Fridoku/gausskanone/README.md

# gausskanone
Fachpraktikum Gausskanone WS1920
