Fridoku/gausskanone/Slide_master_16_9_option1.pptx

## Gausskanone Leistungselektronik

## Schaltplan der Platine

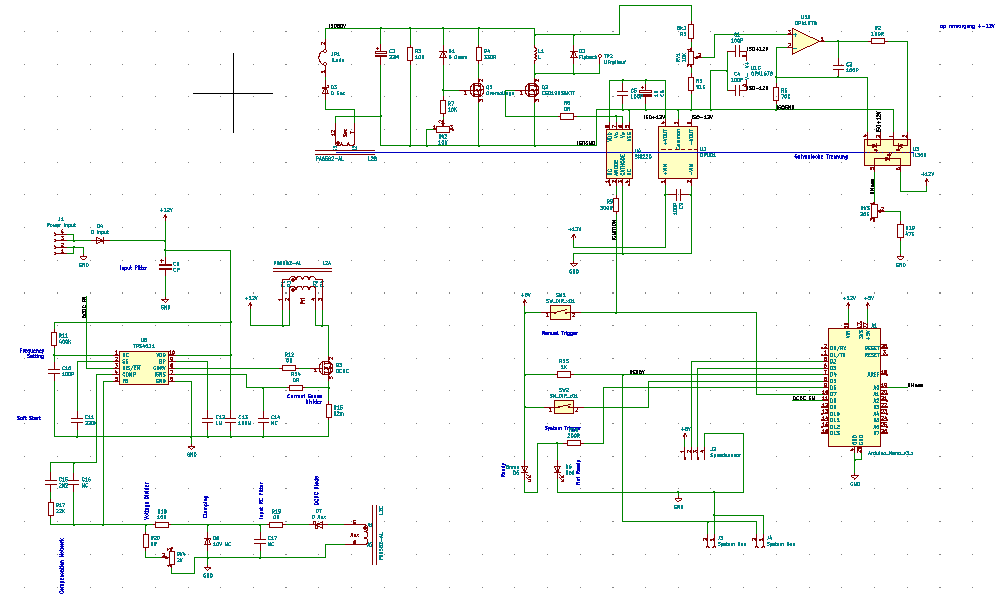
[picture p1: figure]

## Platine

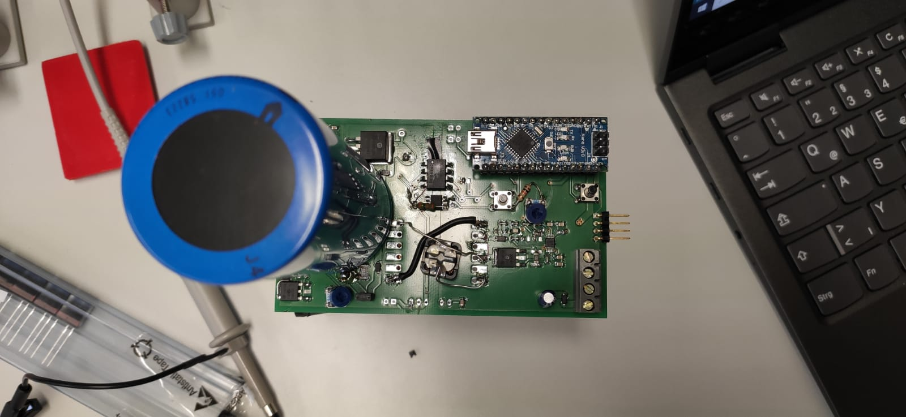
[picture p2: figure]

## Kondensator- und Spulenkreis

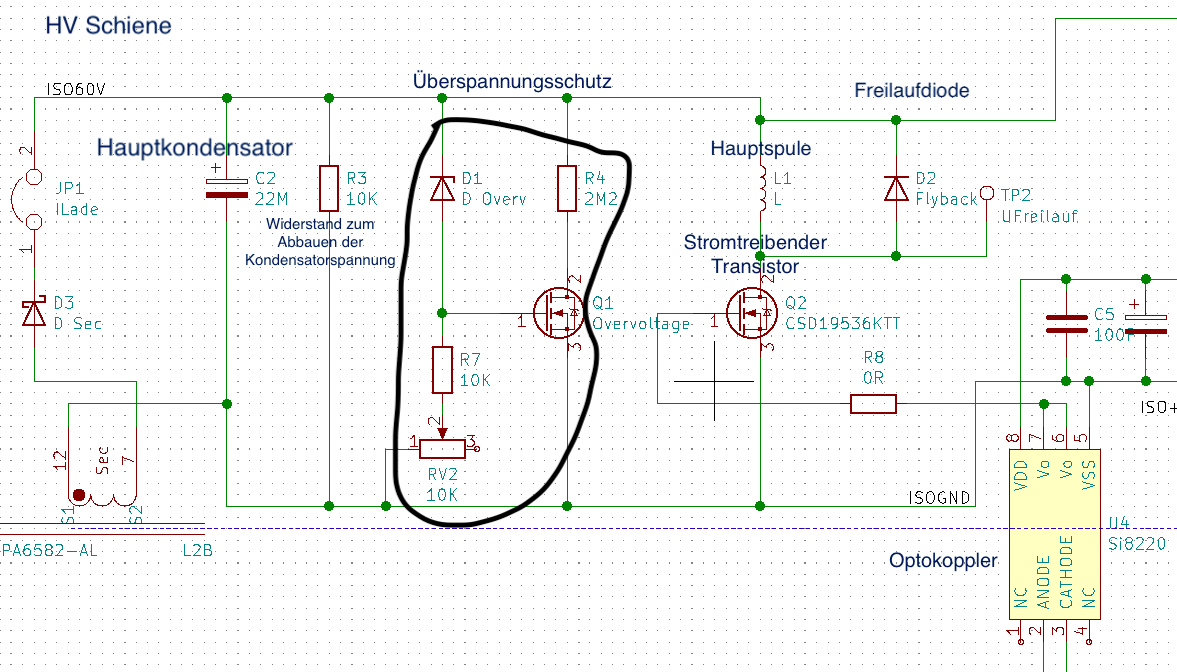
[picture p3: figure]

## Überspannungsschutz

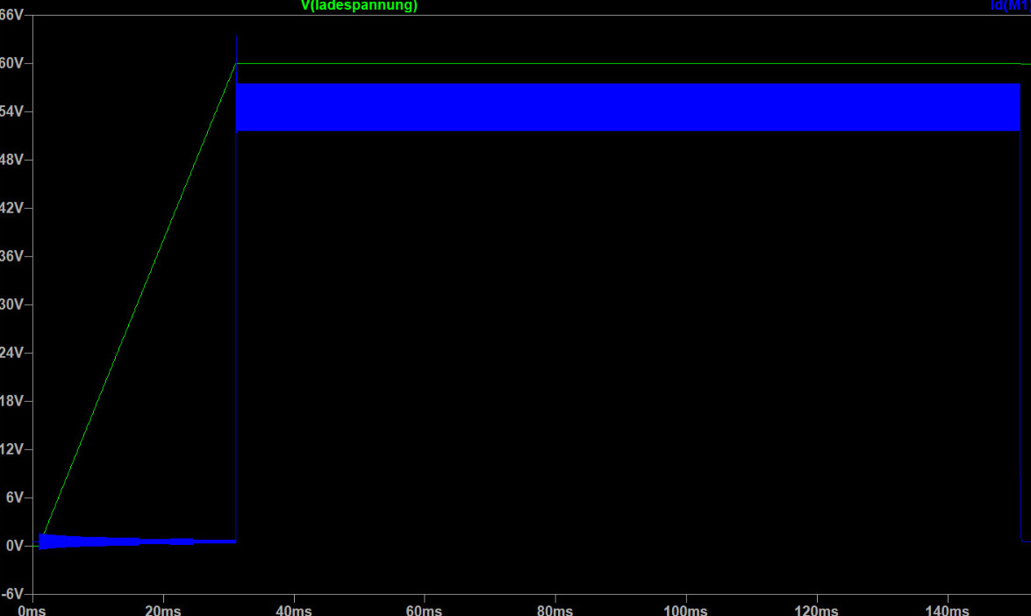
[picture p4: figure]
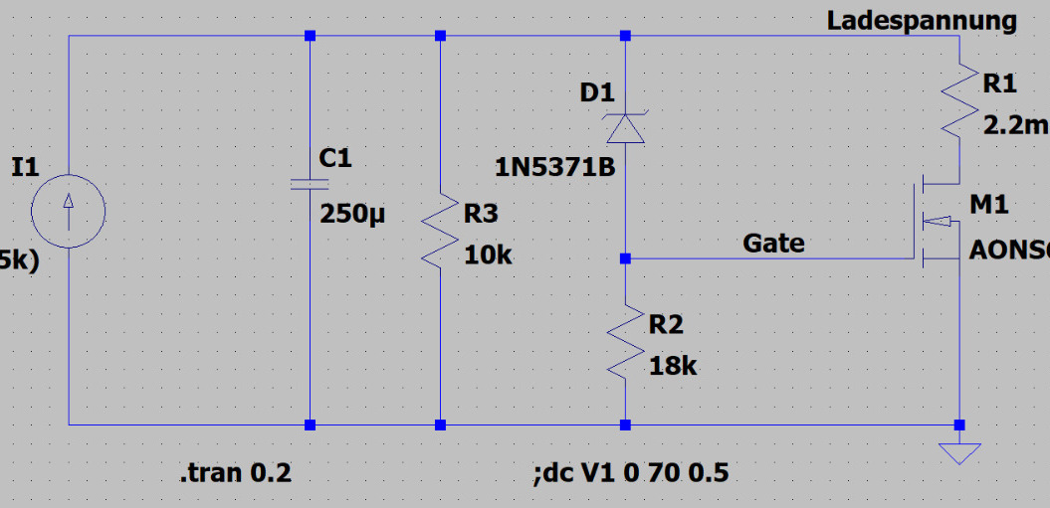
[picture p5: figure]

## Optokoppler
