Fridoku/gausskanone/gausskanone/gausskanone.kicad_pcb

## KiCad design gausskanone/gausskanone.kicad_pcb (2020-01-22)

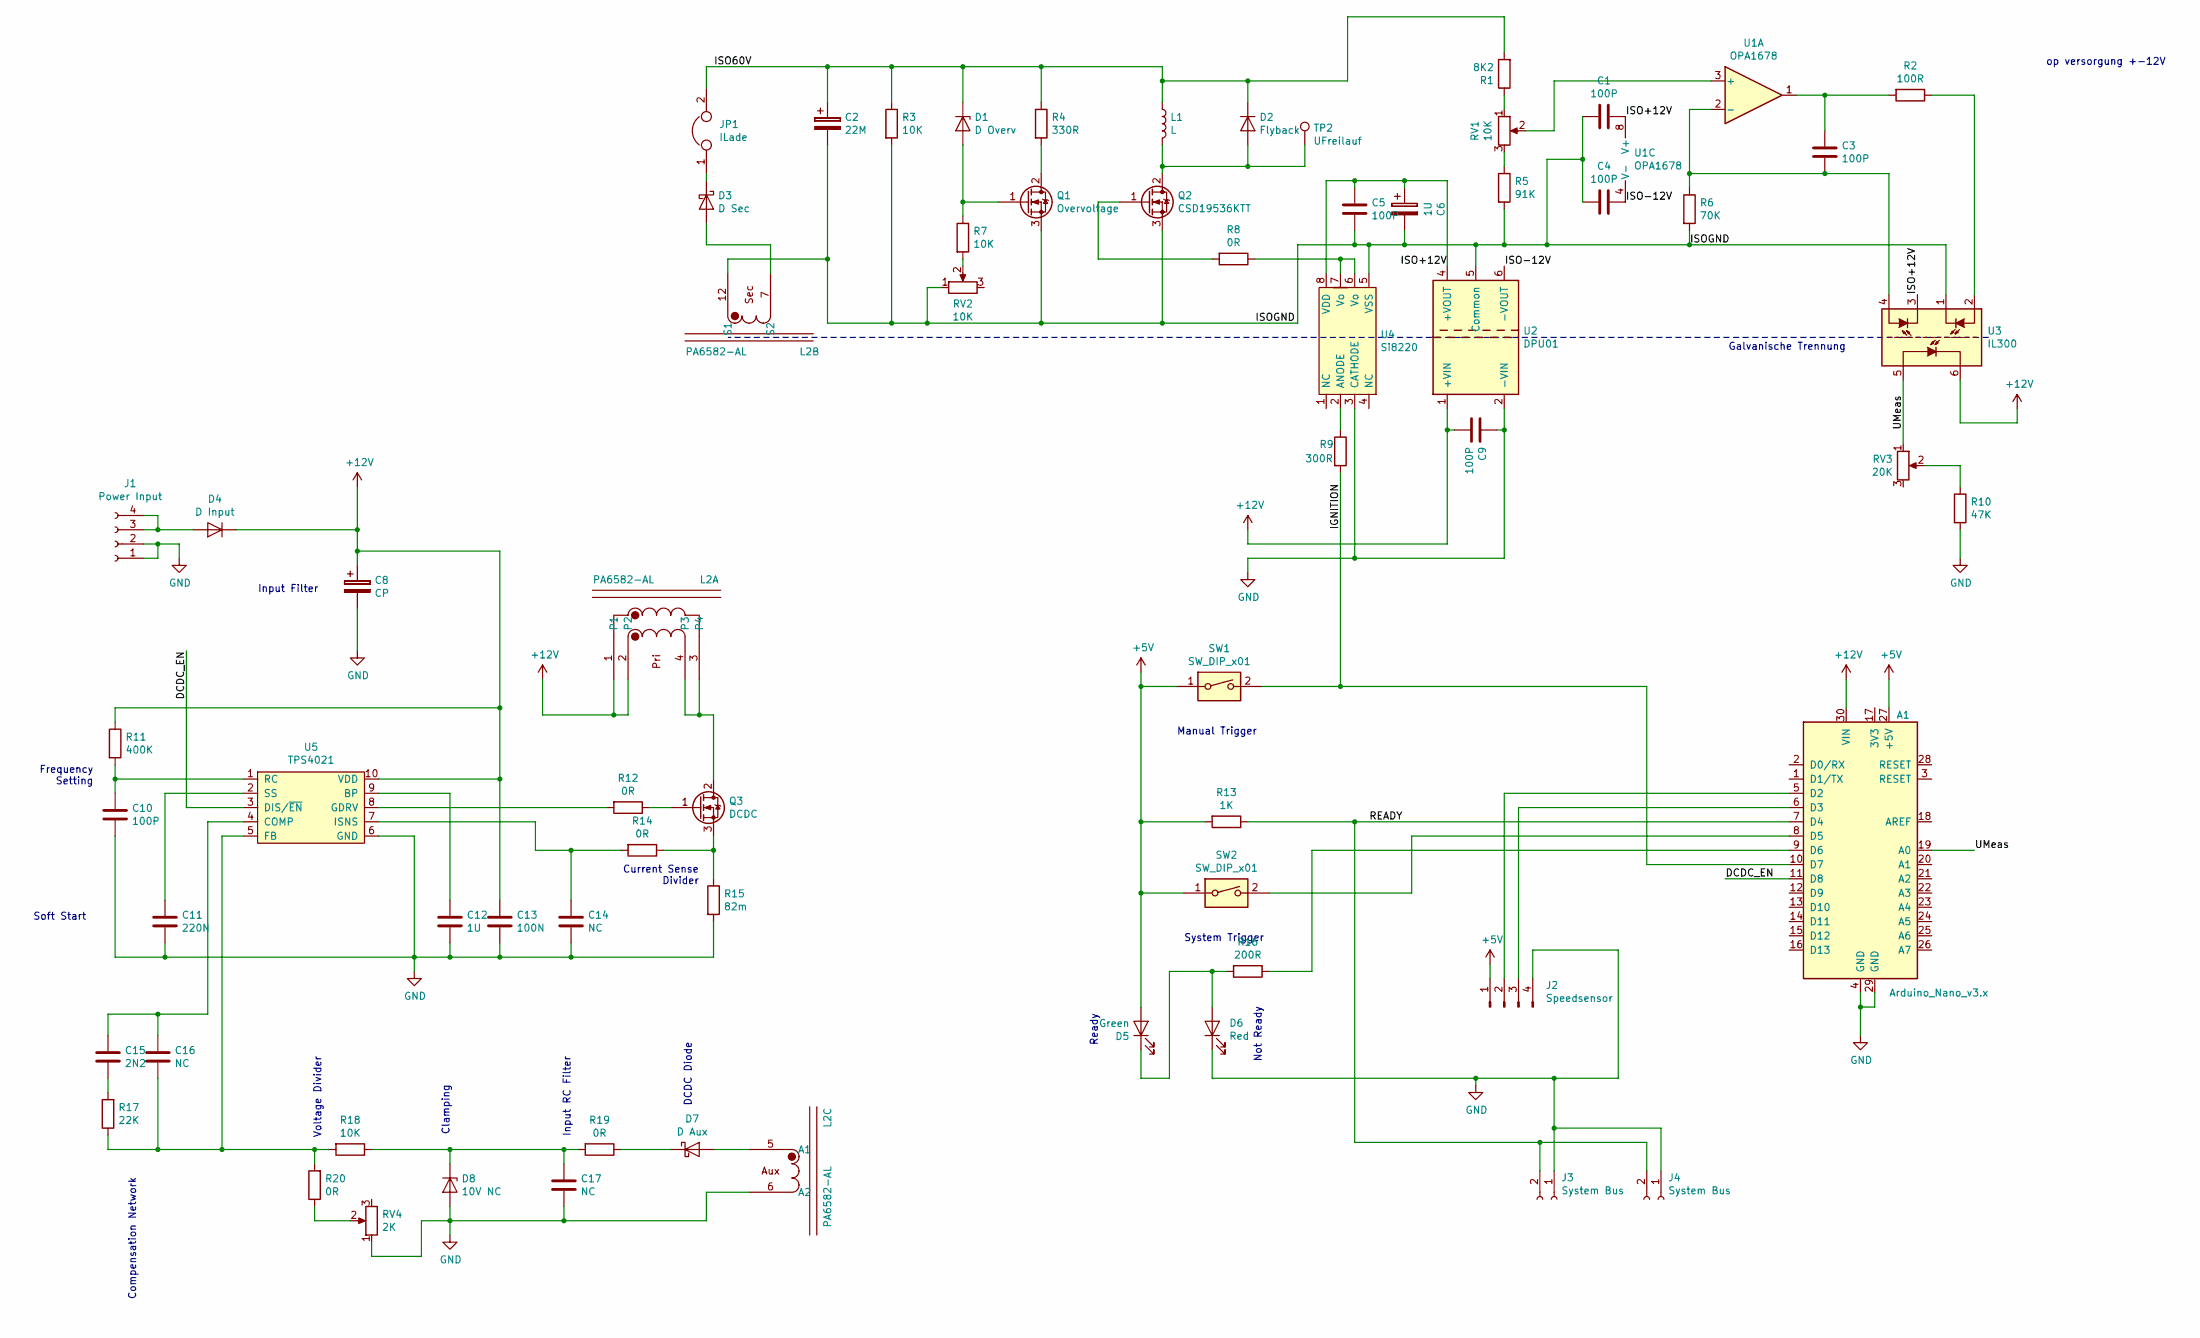
[picture p9: schematic gausskanone.sch]

Parts:
A1: Arduino_Nano_v3.x; Arduino_Nano
C1, C3, C4, C5, C9, C10: 100P; C_0805_2012Metric
C2: 22M; BC 58223
C6: 1U; CP_Radial_D6.3mm_P2.50mm
C8: CP; CP_Radial_D8.0mm_P2.50mm
C11: 220N; C_0805_2012Metric
C12: 1U; C_0805_2012Metric
C13: 100N; C_0805_2012Metric
C14, C16, C17: NC; C_0805_2012Metric
C15: 2N2; C_0805_2012Metric
D1: D Overv; D_SOD-123
D2: Flyback; D_SOD-123F
D3: D Sec; D_SOD-123F
D4: D Input; D_SOD-123F
D5: Green; LED_0805_2012Metric_Castellated
D6: Red; LED_0805_2012Metric_Castellated
D7: D Aux; D_SOD-123
D8: 10V NC; D_SOD-123
J1: Power Input; TerminalBlock_RND_205-00289_1x04_P5.08mm_Horizontal
J2: Speedsensor; PinHeader_1x04_P2.54mm_Vertical
J3, J4: System Bus; PinHeader_1x02_P2.54mm_Vertical
JP1: ILade; PinHeader_1x02_P2.54mm_Vertical
L1: L; GK-L01
L2: PA6582-AL; PA582-AL
Q1: Overvoltage; TO-252-3_TabPin2
Q2: CSD19536KTT; TO-263-3_TabPin2
Q3: DCDC; TO-252-3_TabPin2
R1: 8K2; R_0805_2012Metric
R2: 100R; R_0805_2012Metric
R3: 10K; R_1812_4532Metric
R4: 330R; R_1812_4532Metric
R5: 91K; R_0805_2012Metric
R6: 70K; R_0805_2012Metric
R7, R18: 10K; R_0805_2012Metric
R8, R12, R14, R19, R20: 0R; R_0805_2012Metric
R9: 300R; R_0805_2012Metric
R10: 47K; R_0805_2012Metric
R11: 400K; R_0805_2012Metric
R13: 1K; R_0805_2012Metric
R15: 82m; R_1812_4532Metric
R16: 200R; R_0805_2012Metric
R17: 22K; R_0805_2012Metric
RV1, RV2: 10K; Potentiometer_Bourns_3339P_Vertical
RV3: 20K; Potentiometer_Bourns_3339P_Vertical
RV4: 2K; Potentiometer_Bourns_3339P_Vertical
SW1, SW2: SW_DIP_x01; SW_PUSH_6mm_H7.3mm
TP2: UFreilauf; TestPoint_Loop_D1.80mm_Drill1.0mm_Beaded
U1: OPA1678; SOIC-8_3.9x4.9mm_P1.27mm
U2: DPU01
U3: IL300; PowerIntegrations_SMD-8
U4: Si8220; SOIC-8_3.9x4.9mm_P1.27mm
U5: TPS4021; S-PDSO-G10

Connections:
+5V: A1.27 (+5V), D5.2 (A), J2.1, R13.2, SW1.1, SW2.1
+12V: A1.30 (VIN), C8.1, C9.2, C13.1, D4.1 (K), L2.1, L2.2, R11.1, U2.1 (+VIN), U3.6, U5.10 (VDD)
/DCDC_EN: A1.11 (D8), U5.3 (DIS/~EN)
/IGNITION: A1.10 (D7), R9.2, SW1.2
/ISO60V: C2.1, D1.1 (K), D2.1 (K), JP1.2, L1.1, R1.2, R3.1, R4.1
/ISO+12V: C1.1, C5.1, C6.1, U1.8 (V+), U2.4 (+VOUT), U3.3, U4.8 (VDD)
/ISO-12V: C4.1, U1.4 (V-), U2.6 (-VOUT)
/ISOGND: C1.2, C2.2, C4.2, C5.2, C6.2, L2.12 (S1), Q1.3 (S), Q2.3 (S), R3.2, R5.2, R6.2, RV2.1, U2.5 (Common), U3.1, U4.5 (VSS)
/READY: A1.7 (D4), J3.2, J4.2, R13.1
/UMeas: A1.19 (A0), RV3.1, U3.5
GND: A1.4 (GND), A1.29 (GND), C8.2, C9.1, C10.2, C11.2, C12.2, C13.2, C14.2, C17.2, D6.1 (K), D8.2 (A), J1.1, J1.2, J2.4, J3.1, J4.1, L2.6 (A2), R10.2, R15.2, RV4.1, U2.2 (-VIN), U4.3 (CATHODE), U5.6 (GND)
unnamed: A1.5 (D2), J2.2
unnamed: A1.6 (D3), J2.3
unnamed: A1.8 (D5), SW2.2
unnamed: A1.9 (D6), R16.1
unnamed: C3.1, R2.2, U1.1
unnamed: C3.2, R6.1, U1.2 (-), U3.4
unnamed: C10.1, R11.2, U5.1 (RC)
unnamed: C11.1, U5.2 (SS)
unnamed: C12.1, U5.9 (BP)
unnamed: C14.1, R14.2, U5.7 (ISNS)
unnamed: C15.1, C16.1, U5.4 (COMP)
unnamed: C15.2, R17.2
unnamed: C16.2, R17.1, R18.2, R20.2, U5.5 (FB)
unnamed: C17.1, D8.1 (K), R18.1, R19.2
unnamed: D1.2 (A), Q1.1 (G), R7.1
unnamed: D2.2 (A), L1.2, Q2.2 (D), TP2.1
unnamed: D3.1 (K), JP1.1
unnamed: D3.2 (A), L2.7 (S2)
unnamed: D4.2 (A), J1.3, J1.4
unnamed: D5.1 (K), D6.2 (A), R16.2
unnamed: D7.1 (K), R19.1
unnamed: D7.2 (A), L2.5 (A1)
unnamed: L2.3 (P4), L2.4 (P3), Q3.2 (D)
unnamed: Q1.2 (D), R4.2
unnamed: Q2.1 (G), R8.2
unnamed: Q3.1 (G), R12.1
unnamed: Q3.3 (S), R14.1, R15.1
unnamed: R1.1, RV1.1
unnamed: R2.1, U3.2
unnamed: R5.1, RV1.3
unnamed: R7.2, RV2.2
unnamed: R8.1, U4.6 (Vo), U4.7 (Vo)
unnamed: R9.1, U4.2 (ANODE)
unnamed: R10.1, RV3.2
unnamed: R12.2, U5.8 (GDRV)
unnamed: R20.1, RV4.2
unnamed: RV1.2, U1.3 (+)

Notes on the sheet:
System Trigger
Ready
Not Ready
Manual Trigger
Input Filter
Current Sense Divider
Soft Start
Frequency Setting
Compensation Network
Voltage Divider
Clamping
Input RC Filter
DCDC Diode
Galvanische Trennung
op versorgung +-12V

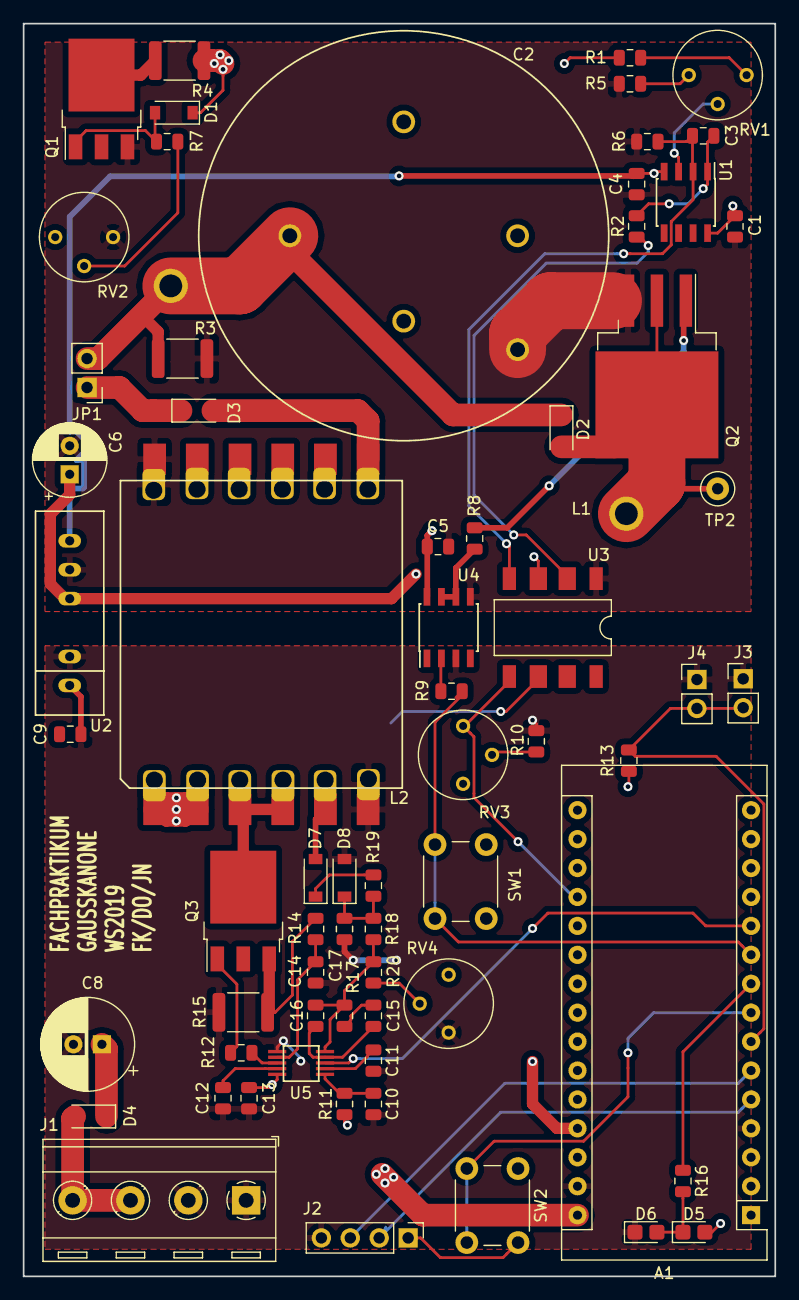
[picture p10: board gausskanone.kicad_pcb from above]

Board: 2 copper layers, 66.0 x 110.0 mm, 67 parts (1 on the bottom side), 48 nets.
