Fridoku/gausskanone/(commit log)

2019-11-25 Design vom 3. Treffen
    [gausskanone.kicad_pcb, gausskanone.sch]
2019-11-27 Doku Flyback
    [gausskanone.sch]
2019-12-04 Added DCDC Converter
    [gausskanone.sch]
2019-12-04 Termin 4.12
    [gausskanone.sch]
2019-12-11 Termin 11.12
    [gausskanone.sch]
2019-12-11 Changes i made
    [gausskanone.sch]
2019-12-18 PCB ready for order
    [BOM.csv, BOM.ods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]
